syw963/newton-acoustic-camera/작업파일/빔포밍/예시결과/두음원/direction.png

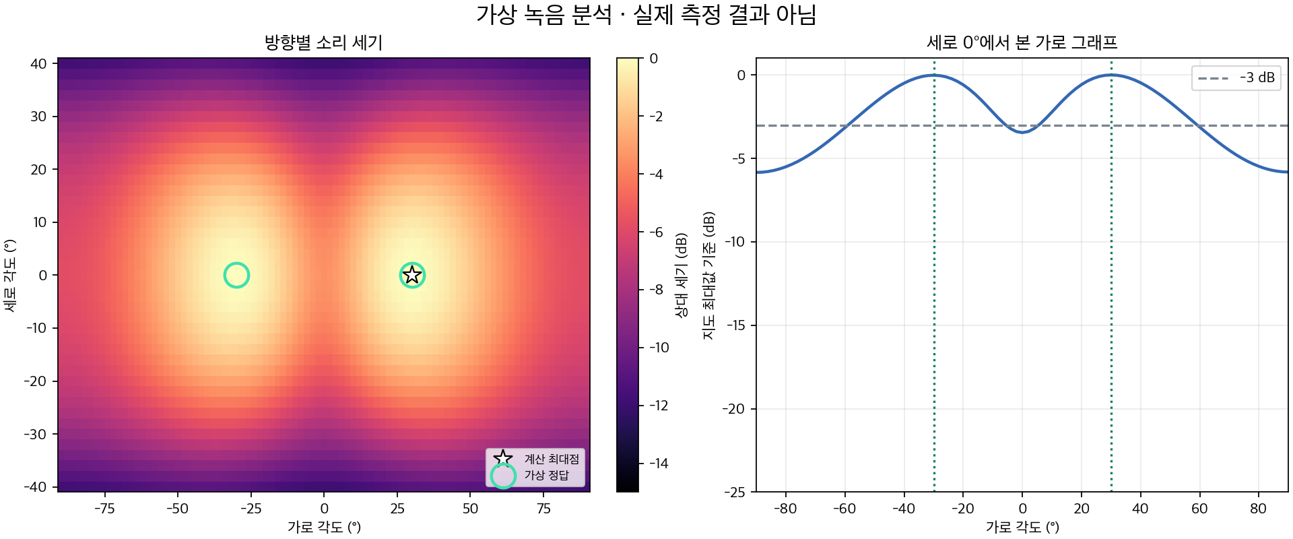
작업파일/빔포밍/예시결과/두음원/direction.png
