syw963/newton-acoustic-camera/README.md

# 뉴턴 음향카메라

물리 동아리(민족사관고) 활동. UMA-16 v2 마이크 배열과 카메라로 음향카메라를 만들고, 소리 방향 추정의 정확도를 빔포밍과 딥러닝으로 비교한다. 기간 8주, 인원 4~6명.

## 폴더 구성

| 경로 | 내용 |
|---|---|
| `진행상황.md` | 날짜별 진행 기록, 현재 상태, 다음 할 일 |
| `설계_및_결정사항.md` | 확정된 장치 설계, 요구서 작성 규칙, 확인이 필요한 것 |
| `CLAUDE.md` | Claude와 작업할 때의 지침 |
| `요구서/` | 학교 제출용 물품 구입 요구서 (xls) |
| `문서/` | 실험 계획서, 배선 작업 순서, 프로젝트 소개 문서, 장치 구상도 |
| `문서/보관/` | 이전 판 (10/15 선생님 제출본 계획서, 계획서 초안) |
| `작업파일/` | 요구서·계획서를 다시 만들 때 쓰는 원본, 아두이노 스케치, 실험용 소리 파일 |

## 현재 최종본

- **요구서 (제출본):** `요구서/음향카메라_물품구입요구서_100만원.xls`
- **요구서 (기존 버전):** `요구서/음향카메라_물품구입요구서_기존버전.xls` (보쉬 드릴, 하코 FX-888DX 등 상위 구성)
- **실험 계획서 (10/26 수정판):** `문서/음향카메라_실험계획서.docx` (수정용), `.pdf` (4쪽, 금액 없음). 10/15에 드린 판은 `문서/보관/음향카메라_실험계획서_1015제출본.*`
- **배선 작업 순서:** `문서/배선_작업순서.md` — 연결표, 단계별 확인, 문제 해결
- **프로젝트 소개 문서:** `문서/음향카메라_프로젝트_소개.docx`, `.md` (10/7 처음 구상. 실험 순서·예산이 바뀐 구버전이라는 안내를 맨 앞에 넣음)
- **장치 구상도:** `문서/음향카메라_장치구상도.html` (브라우저로 열기. 10/26 수정판 설계 반영)

## 방향 계산 실행과 결과

UMA-16과 스피커 A를 연결하고 프로젝트 폴더의 터미널에서 다음을 실행하면 시험 소리 재생·녹음·방향 계산·결과 저장을 한 번에 수행한다.
다른 컴퓨터의 최초 설치 방법과 실제 마이크 녹음 입력법은 [빔포밍 안내](작업파일/빔포밍/README.md)에 있다.

```sh
.venv/bin/python 작업파일/빔포밍/main.py --record
```

USB 단자가 아래인 UMA-16의 확인된 채널 순서를 기본으로 사용한다. 출력은 앰프로 연결한 이어폰 단자로 선택한다.
결과 폴더의 `direction.png`가 그림, `summary.csv`가 각도 요약, `recording.wav`가 원본이다.
장비 없이 시험하려면 `--record` 대신 `--demo`를 사용한다. 실제 장비의 방향 정확도는 후속 측정으로 확인한다.

바로 볼 수 있는 결과: [단일 음원 그림](작업파일/빔포밍/예시결과/단일음원/direction.png) · [요약 표](작업파일/빔포밍/예시결과/단일음원/summary.csv) · [두 음원 그림](작업파일/빔포밍/예시결과/두음원/direction.png).
이 예시는 **가상 16채널 녹음**으로 생성했으며 실제 장비의 측정 결과가 아니다. CSV는 엑셀·Numbers에서 열 수 있다.

## 작업파일

- `작업파일/빔포밍/` — 현재 방향 계산의 개발 위치. 계획서의 지연-합 빔포밍으로 녹음의 방향별 세기·최대 방향·소리 지도를 계산한다. 목적·입출력·실행법은 폴더의 `README.md`. UMA-16 직접 녹음·실제 WAV·가상 녹음 지원, 실물 정확도는 미검증.
- `작업파일/방향추정/locate_sound.py` — 이전 단계의 도착 시간차 연습 코드. 추가 설치 없이 `python3 작업파일/방향추정/locate_sound.py --demo`로 실행한다. 계획서의 지연-합 빔포밍 개발은 위 폴더에서 이어 간다.
- `작업파일/실험계획서/content.py` — 계획서 본문. 고친 뒤 `python build2.py`(pdf) → `node make.js`(docx)
- `작업파일/아두이노/turntable/turntable.ino` — 회전판 제어·배선 테스트 (명령: `?`, `w`, `e1/e0`, `m`, `h`, `g`, `z`)
- `작업파일/신호/make_signals.py` — 실험용 소리 파일 생성. 만들어 둔 파일은 `signals/` (채널 확인용 `00_채널확인.wav` 포함)
- `작업파일/요구서/` — 요구서 작업본 xlsx

## 관련 링크

- 프로젝트 소개 문서 (Claude Docs): https://claude.ai/code/artifact/5a2a508f-ef5b-42dd-a944-30aa85363ba6
- 장치 구상도 (HTML): https://claude.ai/artifact/AYDeXSYpjeCekpr5JsAYyh — 10/26 오전 설계 기준. 폴더의 html(검토 반영판)이 더 최신
