syw963/newton-acoustic-camera/설계_및_결정사항.md

# 설계 및 결정사항

## 탐구 질문과 실험

1. **방향 정확도와 빔 폭 (실험 1):** 회전판으로 배열을 −60°~+60° 범위에서 5° 간격으로 돌리며 측정한다.
   - 스피커 A는 1.5m 앞에 둔다.
   - 1·2·4·6·8 kHz 순음과 백색잡음을 쓰고, 3회 반복한다.
   - 기온으로 음속을 보정한다: v = 331.3 + 0.606T.
   - 빔포밍 계산 범위는 ±90°로 두고, 카메라 화면에 겹칠 때만 화각(가로 약 ±40°)으로 자른다.
   - 보정 전 치우침(평균 오차)과 흩어짐(표준편차)을 따로 보고한다. 0° 보정에 쓴 치우침을 정확도에 섞지 않는다.
   - 빔포밍 방향을 0°로 고정하고 회전 데이터를 그리면 실측 빔 패턴이 된다. 이것으로 주파수별 빔 폭을 재고, 6·8 kHz에서 앨리어싱을 본다.
2. **분해능 (실험 2):** 스피커 A·B 사이 각도 Δθ를 줄여 가며 두 봉우리 사이에 골이 생기는 최소 Δθ를 찾는다.
   - 시작 각도: 2 kHz 90°, 4 kHz 50°, 6·8 kHz 30°. 5°씩 줄이고, 합쳐지는 근처에서는 2.5°씩 줄인다. 1 kHz는 분리되지 않음을 보는 대조 조건이다.
   - 소리는 좌우 채널에 서로 다른 난수로 만든 1/3옥타브 대역 잡음이다. 같은 주파수 순음 두 개는 결맞음이라 쓰지 않는다. 파일은 `작업파일/신호/make_signals.py`로 만든다.
   - Δθ는 회전판으로 잰다. 스피커를 하나씩 켜서 정면(0°)에 오는 모터 각도의 차이를 쓰고, 줄자는 확인용으로만 쓴다.
   - 이론값 0.886 λ/D, D = 4 × 42 = 168mm. 정확한 계산값은 2 kHz 약 55°, 4 kHz 약 27°, 6 kHz 약 18°이다. 골이 생기기 시작하는 Δθ는 빔 폭(−3 dB)과 거의 같다.
   - 앨리어싱 시작 주파수는 음원 방향에 따라 다르다: 정면 음원 약 8.2 kHz, 20° 약 6.1 kHz, 35° 약 5.2 kHz, 60° 약 4.4 kHz. 4 kHz 이하에서는 생기지 않는다.
3. **빔포밍 vs 딥러닝 (실험 3):** 연필 0° 표시와 `o` 명령으로 원점을 잡고(단순판에는 리밋 스위치가 없음) ±60° 안의 무작위 각도(연속값)로 데이터를 자동 수집한다. 코드는 `작업파일/딥러닝/`.
   - 시작할 때와 50회마다 0°로 돌아가 빔포밍이 ±3° 안인지 확인하고, 어긋나면 멈춘다(스텝 손실 확인).
   - 시험 데이터는 다른 공간, 다른 날, 다른 거리 중 하나 이상이 다른 조건에서 따로 모은다. 같은 세션의 데이터를 무작위로 나눠 시험하지 않는다(data leakage).
   - 입력은 GCC-PHAT(120쌍 × ±32표본, 300~8000 Hz), 출력은 연속 각도(regression). 신경망은 1차원 합성곱(약 30만 매개변수). 가짜 녹음으로 사전 학습한 뒤 실제 데이터로 이어서 학습한다. 학습은 Mac에서도 되며, 데이터가 많아지면 RunPod에서 한다.
   - 세션 구분: 학습 세션 여러 개, 검증 세션 1개(다른 거리), 시험 세션 1개(다른 장소). 학습 중 가장 좋은 모델은 검증 세션으로 고른다.
   - 비교 대상은 지연-합 빔포밍, SRP-PHAT, MUSIC이다. 평균 오차와 최대 오차를 비교한다.

일정(임의 배분): 1~3주 장치 제작, 4주 실험 1, 5주 실험 2, 6~8주 실험 3.

## 장치 설계

**회전판 구성**
- 12mm 자작합판 상자, NEMA17(17HS4401) 모터
- 아두이노 UNO + CNC 쉴드 V3 + A4988 (1/16 마이크로스텝, 3200스텝/회전), 12V 2A 전원
- 이동은 매번 원점 기준 절대 스텝 수(각도 ÷ 360 × 3200, 반올림)로 한다.
- 제어 스케치: `작업파일/아두이노/turntable/turntable.ino` (명령 ? w e m h g z o)

**재단 치수:** 600×600 원판 2장 중 1장만 재단하고, 1장은 여분이다.

| 부품 | 치수 (mm) | 수량 |
|---|---|---|
| 바닥판·모터판 | 250×250 | 2 |
| 회전판 | 200×200 | 1 |
| 세움판 | 220×170 | 1 |
| 옆벽 | 250×70 | 2 |

**단순판 (2026-11-12 결정)** 제작이 너무 어려워 아래처럼 바꿨다. 순서는 `문서/회전판_제작가이드_단순판.html`(claude.ai 아티팩트)을 따른다. 11/4 가이드는 참고용으로 남긴다.
- 레이지수전 아랫판은 목재 나사 3.5×10으로 모터판에 박는다(윗판을 45° 돌려 모서리 구멍을 드러냄). 윗판은 얇은 양면테이프로 회전판에 붙인다. 회전은 플랜지가 시키고 레이지수전은 무게만 받으므로 볼트·너트·접근 구멍이 필요 없다.
- 리밋 스위치를 달지 않는다. 원점은 회전판과 모터판 앞 모서리의 0° 연필 표시를 맞춘 뒤 `o`로 정하고, 정면 스피커를 빔포밍으로 재서 미세 조정한다. 켤 때마다 다시 한다.
- 접시 구멍은 바닥판 아랫면 6곳만 판다. 세움판 나사를 레이지수전 자리(축에서 ±76) 바깥인 x = ±84, ±94로, 받침대 나사를 x = ±90으로 옮겨 회전판 아랫면 접시 구멍을 없앴다.
- 플랜지 볼트 구멍은 Ø4. 플랜지는 X자(대각선)로 놓아 뒤쪽 볼트 머리가 세움판에 닿지 않게 한다. 회전판 가운데를 5 mm로 먼저 뚫고 5 mm 비트를 핀으로 써서 플랜지를 가운데에 맞춘다.
- 커플링 높이 H = 모터판 두께 + 레이지수전 높이(약 21), 모터 앞면에서 플랜지 윗면까지.
- 카메라는 세움판 윗모서리 가운데에 집게로 끼운다(Ø32 구멍 없음).
- 모터판 구멍은 `문서/모터판_구멍본.pdf`(실제 크기)를 대고 뚫는다.

**레이지수전 회전 베어링**
- 사각 6인치, 높이 9mm. 모터판과 회전판 사이에 넣어 회전판 무게를 받는다.
- 볼트 세트의 M4×20+너트로 고정한다. 윗판은 회전판에 먼저 고정하고, 아랫판은 레이지수전을 45° 돌려 드러난 모서리 구멍을 9mm 틈으로 조인다.

**플랜지 커플링 (5mm)**
- 회전판 아랫면에 붙이고, 통 부분이 모터판의 Ø25 구멍 안으로 들어가게 한다.
- 모터 축 끝이 회전판을 약 3mm 넘으므로 회전판 가운데에 Ø8 구멍을 뚫는다.

**조립 순서 (조립 후에는 커플링 고정나사에 렌치가 닿지 않음)**
1. 커플링을 모터 축에 먼저 끼우고 고정나사(무두볼트)를 조인다.
2. 모터를 모터판 아래에서 올려 M3×16으로 고정한다. 커플링이 Ø25 구멍을 통과해야 한다.
3. 레이지수전 윗판을 회전판에 고정한다.
4. 레이지수전 아랫판을 모터판에 고정한다.
5. 회전판을 덮고 플랜지를 회전판에 고정한다.

물품이 오면 확인할 것:
- 플랜지 지름이 25mm보다 크면 모터판 구멍을 32mm 스페이드 비트로 넓힌다. 모터 볼트 구멍과의 벽 두께는 약 4mm 남는다.
- 커플링 전체 높이가 약 19mm 이하여야 한다. 이 값은 모터 보스 윗면에서 회전판 아랫면까지의 거리이다.
- 플랜지 구멍에 나사산이 있어야 위에서 볼트로 고정할 수 있다. 나사산이 없으면 고정 방법을 다시 정한다.

**고정 볼트**
- 모터: M3×16 4개
- UMA-16: M3 서포트(암-암 10mm)로 10mm 띄운다. 뒤쪽은 M3×16, 앞쪽은 M3×6.

**리밋 스위치** (단순판에서는 달지 않음. 아래는 나중에 달 때 참고)
- OMRON SS-5 장레버를 측정 범위 밖인 약 −70°에 단다. 회전판 아랫면 가장자리의 나사 머리가 레버를 누르게 한다.
- COM은 쉴드 X− 단자의 GND에, NO는 신호 핀(D9)에 연결한다. 눌리면 LOW이다.
- 남는 1개는 +70° 비상 정지로 X+ 단자(같은 D9)에 단다.
- 원점 찾기는 200° 안에서 스위치를 못 찾으면 멈춘다(선이 끊겼을 때 회전판이 계속 도는 것을 막음).

**녹음 중 모터 드라이버**
- A4988은 멈춰 있어도 전류를 흘려 고음 잡음을 낼 수 있다. 무음 녹음을 드라이버를 켠 상태(e1)와 끈 상태(e0)로 비교한다.
- 잡음이 있으면 녹음하는 동안 드라이버를 끈다.
- 드라이버를 끄면 모터가 가장 가까운 정지 위치(1.8° 간격)로 끌려갈 수 있다. 카메라 십자선으로 밀리는지 먼저 확인한다.
- 밀리면 드라이버를 켜 둔 채 녹음하거나, 측정 각도를 1.8°의 배수로 정한다.

**기타**
- 배열 중심 높이는 책상 위 약 200mm이다.
- 0°는 원점을 찾은 뒤 카메라 화면 중앙 십자선으로 맞추고(스케치의 z 명령), 실험 1 결과에서 일정하게 치우친 만큼을 보정한다. 레이저 포인터는 쓰지 않는다.
- 배열과 스피커 사이에서 책상 면에 반사되는 지점(배열 앞 약 0.75m)이 책상 위면 천을 깐다.

**음원**
- 2인치 4Ω 스피커 2개를 합판 통에 넣는다.
- 앰프는 PAM8403 모듈(동신전자 PP-A193)이다. USB 단자가 없으므로 USB 전원 케이블의 DC 플러그를 잘라 5V 단자에 납땜한다. 5V 넘는 전원을 넣지 않는다.
- 노트북 왼쪽 채널은 스피커 A, 오른쪽 채널은 스피커 B로 보낸다. 노트북의 소리 향상·공간 음향 기능은 끈다.
- PAM8403은 BTL 출력이다. L−와 R−를 묶거나 GND에 연결하지 않는다. 스피커마다 2심 선을 따로 쓴다(10m 선을 반으로 자름).
- 배선 순서와 확인 방법은 `문서/배선_작업순서.md`에 있다.

**소리 재생과 동시 녹음** (`작업파일/sh/sound_io.py`, 사용법은 같은 폴더의 `사용법.md`)
- Windows와 Mac에서 같은 코드로 돈다(sounddevice, soundfile). Windows에서는 WASAPI 장치를 고른다. 기본 볼륨 0.3은 `audio.py`와 같다.
- 스피커 선택: A = 왼쪽 채널만, B = 오른쪽 채널만, AB = 파일 그대로. A 전용 파일을 B로 고르면 오른쪽으로 옮겨 낸다.
- 녹음을 먼저 시작하고 0.3초 뒤 재생, 소리가 끝나고 0.5초 뒤 정지한다. 녹음은 16채널, 48 kHz, 16비트 wav이다.
- 재생과 녹음은 서로 다른 장치라 시계가 다르다. 빔포밍은 마이크 사이 시간차만 쓰므로 재생 시작 시각은 참고값(`play_offset_s`)으로만 남긴다.

**드릴 비트**
- 스페이드 비트 25mm: 모터판 구멍 (플랜지가 크면 32mm)
- 스페이드 비트 32mm: 카메라 선 구멍
- HSS 2mm: 나사 기초 구멍
- HSS 4mm: M3 구멍 (여유 있게 뚫어 모터 중심을 맞춤)
- HSS 5mm: M4 구멍
- HSS 8mm: 축 구멍

## 요구서 작성 규칙

- 사용자가 마지막으로 올린 xls를 기준으로 수정한다.
- 링크를 받은 상품만 교체하고, 나머지는 유지한다.
- 가격은 11번가 주문 영역의 할인모음가(자동적용 쿠폰 반영가)로 넣는다.
  - 쿠폰은 화면마다 다를 수 있으므로, 사용자 화면에 보이는 가격이 있으면 그것을 우선한다.
- 행을 넣거나 빼면 다음을 함께 고친다.
  - 번호
  - J열 수식(=D*I)과 합계(SUM)
  - 국내 배송비 금액과 L열 배송비 내역
- 같은 판매처 상품은 묶음배송으로 보고 배송비를 한 번만 넣는다.

## 소프트웨어 초기 연습 (이전 단계, 2026-11-04)

- 사용자는 소프트웨어 팀이며 실제 마이크 녹음 파일은 아직 없다. `작업파일/방향추정/`에 가상 녹음으로 실행할 수 있는 첫 버전을 둔다.
- 첫 출력 좌표는 가로·세로 **각도(도)**이다. 마이크의 앞쪽에 한 음원이 있다고 가정하며 거리나 방 안의 미터 좌표를 추정하지 않는다.
- 계산은 일반 상호상관으로 구한 도착 시간차와 평면파 근사를 쓴다. 실험 계획의 지연-합 빔포밍·GCC-PHAT·딥러닝 구현을 대신하는 완성본은 아니다.
- `mic_positions_example.csv`는 구상도에 있는 좌표의 예시이다. 실제 입력에는 동시 녹음의 각 채널과 순서를 맞춘 별도 좌표 파일이 필요하다. 실제 채널 순서와 좌우·상하 방향을 검증하기 전에는 실험 결과로 사용하지 않는다.
- 실제 녹음을 받으면 넓은 주파수의 한 음원으로 먼저 검증한다. 단일 순음, 여러 음원, 교실 반사음에서의 정확도는 아직 검증하지 않았다.

## 소프트웨어

- 연결: UMA-16·카메라·아두이노는 USB 허브로 노트북에 연결한다. UMA-16은 아두이노에 연결하지 않는다(아두이노는 모터만 다룬다). Mac에서는 "UMA16v2, 입력 16/출력 2"로 보인다.
- 실험 노트북은 Windows와 Mac을 모두 지원한다. 파이썬 3.9 이상, 패키지는 `작업파일/파이썬/requirements.txt`(numpy, pyserial, sounddevice, soundfile).
- 회전판은 `turntable.py`의 `Turntable`로 조작한다. 명령 한 줄을 보내고 `ok`가 올 때까지 기다리며, `err`는 `TurntableError`로 처리한다. `Turntable("sim")`은 turntable.ino를 흉내 내는 시뮬레이터이다.
- 소리는 `audio.py`로 낸다. 스피커 A = 왼쪽 채널, B = 오른쪽 채널, 표본화 주파수 48 kHz. 기본 볼륨 0.3에서 시작한다.
- 조립 전에는 벤치 원점(`o`, `--bench`)으로 책상 위에서 시험하고, 실험에서는 리밋 스위치로 잡은 원점(`h`)만 쓴다.
- 실제 하드웨어를 처음 켤 때는 `hw_check.py`로 점검하고 결과를 `작업파일/파이썬/기록/`에 남긴다.
- UMA-16은 `uma_check.py`로 점검한다(장치 정보, 16채널 레벨, `--map`으로 채널 위치표).
- 지연-합 빔포밍은 `beamform.py`(좌표, 각도별 세기 `scan`, 가짜 녹음 `simulate`)와 `step4_beamform.py`(녹음 → 계산 → `기록/bf_log.csv`)로 한다. 녹음·재생은 팀원의 `작업파일/sh/sound_io.py`를 복사하지 않고 불러 쓴다. 기본 대역 300~4000 Hz, 1/2 겹침 1024점 STFT.

**UMA-16 채널 위치표 (2026-11-11, Mac, 48 kHz)**
- 마이크를 하나씩 긁어 가장 크게 들은 채널을 적었다. 16개 모두 2위 채널보다 6 dB 이상 컸다. 기록: `작업파일/파이썬/기록/uma_map_20261111_155005.md`.
- 위치 기준: 마이크 면을 마주 보고(스피커 쪽에서 배열을 볼 때) 위쪽이 1행, 왼쪽이 1열이다. 이때 USB 단자는 아래쪽에 있었다. 보드를 세움판에 달 때도 마이크 면이 스피커를 보고 USB 단자가 아래로 가게 단다(다르게 달면 표를 돌려서 쓴다).
- 좌표: 배열 중심이 원점, x는 오른쪽 +, y는 위쪽 +, 간격 42mm. 각도 부호는 팀 논의 D3에서 정한다.

| | 1열 (x −63) | 2열 (x −21) | 3열 (x +21) | 4열 (x +63) |
|---|---|---|---|---|
| 1행 (y +63) | ch8 | ch7 | ch10 | ch9 |
| 2행 (y +21) | ch6 | ch5 | ch12 | ch11 |
| 3행 (y −21) | ch4 | ch3 | ch14 | ch13 |
| 4행 (y −63) | ch2 | ch1 | ch16 | ch15 |

- 왼쪽 두 열이 ch1~8, 오른쪽 두 열이 ch9~16이다. 채널 번호는 녹음 파일의 열 순서(1부터)이다.
- `작업파일/파이썬/beamform.py`의 각도 약속(임시, D3에서 확정): 0°는 배열 정면, 배열 뒤(카메라 쪽)에서 스피커를 볼 때 오른쪽이 +θ이다. +θ 쪽에 ch1~8 열이 있어 +θ 소리가 ch1~8에 먼저 닿는다. 11/11 책상 위 시험에서 오른쪽 스피커가 +, 왼쪽 스피커가 −로 나와 위치표와 부호가 맞음을 확인했다. `작업파일/빔포밍/`은 마이크 면을 마주 본 x축을 각도에도 사용하므로 같은 녹음의 가로 부호가 반대이며 비교 시 부호를 바꿔 맞춘다.
- 빔포밍 코드에서 쓰는 좌표(mm, 채널 순서, 0번 = ch1):

```python
MIC_XY_MM = [(-21, -63), (-63, -63), (-21, -21), (-63, -21), (-21, +21), (-63, +21), (-21, +63), (-63, +63),
             (+63, +63), (+21, +63), (+63, +21), (+21, +21), (+63, -21), (+21, -21), (+63, -63), (+21, -63)]
```
- 순서: 하드웨어 조작(완료) → 16채널 녹음 + 지연-합 빔포밍(책상 위, 회전판 없이) → 카메라 겹치기 → 자동 수집 → 실험 3 딥러닝. UMA-16이 일찍 도착해 가짜 데이터 시뮬레이터 단계는 건너뛴다.

**방향 계산의 현재 개발 기준 (2026-11-04)**
- 개발 위치는 `작업파일/빔포밍/`이다. 목적·입출력·좌표·범위·실행법은 해당 폴더의 `README.md`에 정리한다. 이전 시간차 연습 폴더는 보관한다.
- 입력은 동기화된 다채널 WAV, 채널 순서를 확인한 마이크 좌표 CSV, 기온, 분석 주파수 대역이다. 정답 각도나 모터 위치를 계산 함수에 주지 않는다.
- 계획서의 주파수 영역 지연-합 빔포밍을 구현한다. Hann 창·50% 겹침으로 CSM을 평균하고 대각항을 유지한다. 상대 채널 크기를 임의로 같게 만들지 않는다.
- 출력은 최대 방향의 가로·세로 각도, 전체 방향별 세기, 소리 지도와 세로 0°의 가로 그래프이다. 지도 최대값 기준 상대 dB이며 소음도나 정답 확률은 아니다.
- 가로 ±90°, 세로 ±40°, 기본 2° 간격으로 탐색한다. 앞쪽 음원·평면파를 가정하며 거리·미터 좌표를 추정하지 않는다. 기본 대역 500~4000Hz는 실험 주파수에 맞춰 바꾼다.
- 예시 CSV는 가상 시험용이다. 실제 입력은 11/11에 확인한 채널 순서를 옮긴 `mic_positions_uma16_usb_down.csv`를 기본으로 사용한다(USB 아래, 마이크 면을 마주 본 좌표). 다른 방향·다른 채널 순서는 별도의 좌표 CSV를 지정한다. 가상 결과에 실물 측정과 구분되는 표시를 붙인다.
- 구상도 좌표의 최외곽 마이크 중심 간격(126mm)과 기존 근사식의 D(168mm)는 정의를 구분해 검토해야 한다. 이번 빔포밍은 D 근사식을 쓰지 않고 개별 마이크 좌표로 계산한다.
- 현재는 한 번의 녹음 또는 저장된 파일 하나의 방향 계산 단계이다. 연속 실시간 화면·영상 합성·회전판 자동 수집·딥러닝·실험 1~3 전체 평가는 후속 작업이며 실물 정확도는 아직 검증하지 않았다.

**직접 녹음과 방향 계산 연결 (2026-11-11)**
- `main.py --record`로 팀원의 `작업파일/sh/sound_io.py` 원본을 불러와 `exp3_white`를 스피커 A에서 재생하고 UMA-16으로 녹음한 뒤 계산·그림·표 저장까지 이어 간다. 녹음 도구 원본을 복사하거나 수정하지 않는다. 아두이노는 조작하지 않는다.
- 마이크는 16채널·48 kHz, 저장은 PCM16이다. 입력은 UMA-16 자동 선택, 출력은 시스템 기본값이며 `--mic`·`--out`으로 지정할 수 있다. `--devices`는 목록만 표시한다.
- 원본 `recording.wav`를 먼저 보존한다. 녹음 스트림 경고·최대 크기의 99% 이상인 샘플·시험 소리가 잡히지 않은 경우에는 방향 계산을 멈추고 `recording_info.json`에 이유를 적는다.
- 구간은 재생 전 첫 0.2초의 바닥 잡음 대비 3배 이상인 20ms RMS가 0.2초 이상 이어진 가장 긴 부분으로 고른다(최소 RMS 1e-5). 장치 간 시계 차이가 있는 `play_offset_s`로 자르지 않는다. 이는 녹음 상태 선별이며 음원 식별·방향 정확도를 보증하지 않는다.
- 장비를 흉내 낸 통합 시험을 포함해 빔포밍 테스트 18개와 팀원 녹음 도구의 장치 없는 테스트 8개를 통과했다. 이 변경 중 실제 녹음·재생은 실행하지 않았으며 실제 장비 방향 검증은 별도이다.

**결과 출력과 공유 (2026-11-11)**
- 기본 결과는 `작업파일/빔포밍/결과/`에 저장한다. `--output-dir`로 새 저장 폴더를 지정할 수 있으며 기존 폴더를 덮어쓰지 않는다.
- PNG·JSON·NPZ와 함께 요약(`summary.csv`), 가로 그래프(`direction_curve.csv`), 전체 지도(`power_map.csv`)를 출력한다.
- GitHub 공유용 가상 데이터 결과는 `작업파일/빔포밍/예시결과/`에 선별해 보관한다. 실제 측정과 구분하고, 원본 가상 WAV·전용 Python 환경·캐시는 업로드 대상에서 제외한다. 결과 JSON에는 파일 이름을 저장한다.

## 문서 원본

- 실험 계획서 본문은 `작업파일/실험계획서/content.py` 하나에서 고친다.
- `build2.py`를 실행하면 pdf와 data.json이 만들어지고, 이어서 `node make.js`를 실행하면 docx가 만들어진다. 결과는 `문서/`에 저장된다.
- 실험용 소리 파일은 `작업파일/신호/make_signals.py`로 만든다.

## 확인이 필요한 것 / 주의

- **11번가 판매 종료:** 자주 일어난다. 10/13 PAM8403, 10/14 커플링·모터 케이블이 내려갔다. 주문 직전에 다시 확인한다.
- **Claude가 열 수 없는 페이지:** 쿠팡과 네이버 스마트스토어. 사용자가 직접 확인한다.
- **해외직배송 상품:** 드릴(Tempo11)과 커플링은 해외직배송이라 도착이 늦을 수 있다. 요구서 납품기한(10/28)과 맞지 않는다.
- **UMA-16 비용:** 국제 배송비($30)와 관세는 결제 화면에서 확정되는 예상값이다. 환율 1,350원은 10/26 시세(약 1,323원)보다 여유 있게 잡은 값이다.
- **요구서 배송비 내역:** 판매처 4곳(#4 스테핑모터 컨트롤러, #7 웨이투샵, #19 에이치케이오토모바일, #35 동백산업)이 유료·무료 어느 쪽에도 적혀 있지 않다. 모두 유료여도 약 1.2만 원이라 100만 원 안이다.
- **100만 원 버전의 한계:** 등급을 낮춘 품목은 드릴(WORX 12V), 스페이드 비트(포스너 대신), 미니톱이다.
