syw963/newton-acoustic-camera/진행상황.md

# 진행상황

## 현재 상태 (2026-11-13)

- 구입 요구서: 100만 원 버전 확정 (974,655원). 선생님 검토 중. 요구서 파일은 이번에 고치지 않음.
- 실험 계획서: 10/15에 선생님께 드린 판(`문서/보관/…_1015제출본`)에서 실험 1~3을 고친 수정판을 만듦 (docx, pdf 4쪽). 선생님께 다시 드릴지는 아직 정하지 않음.
- 배선: 배선 작업부터 시작할 예정. 순서·확인 방법은 `문서/배선_작업순서.md`, 테스트 스케치와 소리 파일 준비됨.
- 부품 도착: UMA-16이 도착해 모든 물품이 도착함(11/11). Mac 오디오 MIDI 설정에서 "UMA16v2, 입력 16/출력 2"로 인식됨. 표본화 주파수 48 kHz 확인, 16채널 모두 동작, 채널 위치표 작성(`uma_check.py`, 설계_및_결정사항.md, USB 단자 아래 기준).
- 연결 구조: UMA-16·카메라·아두이노는 USB 허브로 노트북에 연결한다. UMA-16은 아두이노에 연결하지 않는다(아두이노는 모터만).
- 장치 제작(목공): 시작 전. 제작 가이드(`문서/음향카메라_제작가이드.html`, claude.ai 아티팩트)를 만듦. 실측 후 팀 논의(D1~D7)로 확정할 예정.
- 소프트웨어: 하드웨어 조작 첫 단계 코드(`작업파일/파이썬/`)와 팀 소개 페이지(`문서/소프트웨어_첫걸음.html`, claude.ai 아티팩트)를 만듦. 실제 하드웨어용 점검 스크립트(`hw_check.py`)와 조립 전 벤치 원점(`o`)을 추가함. 시뮬레이터로만 시험했고 실제 아두이노·스피커로는 아직 안 돌려 봄.
- 소리 재생 자동화(소프트웨어 팀원 담당, 작업 폴더 `작업파일/sh/`): `sound_io.py` 첫 판. 재생(A만/B만/AB, 반복), UMA-16 동시 녹음, Windows·Mac 공용. 장치 없는 시험, Windows 이어폰 시험(좌우·높낮이), Windows selftest(노트북 스피커·마이크로 동시 재생·녹음) 통과, Mac 시험 통과(팀장). 앰프·스피커 배선 완료(하드웨어 팀). 실제 스피커 시험 통과(A/B 방향, 잡음 없음, 앰프 볼륨 위치 정함). UMA-16은 아직 안 함.
- 딥러닝(실험 3, 11/13): `작업파일/딥러닝/`에 수집 → 특징(GCC-PHAT) → 학습 → 4가지 방법 비교 파이프라인을 만듦. 가짜 녹음으로 끝까지 돌아감(DNN 평균 오차 0.50°). 실제 녹음에는 아직 맞지 않아(빔포밍과 10~25° 차이) 회전판 수집 데이터가 필요함.
- 장치 구상도: 수정판 설계를 반영함. claude.ai 아티팩트는 아직 이전 버전.
- GitHub: 공개 저장소 syw963/newton-acoustic-camera에 폴더를 올림(11/3). 실명이 든 요구서 xls·작업본 xlsx는 제외. 로컬 폴더도 git 저장소로 연결함(origin/main).
- 방향 계산: 사용자는 소프트웨어 팀이며 실제 마이크 녹음 파일은 아직 없음. 목적·입출력을 정리하고 `작업파일/빔포밍/`에 계획서의 지연-합 빔포밍을 구현함. 가상 녹음 및 WAV 입력 → 방향별 세기·최대 방향 → PNG·JSON·NPZ 저장을 지원함. 가상 데이터 테스트 10개 통과. 실제 장비 정확도는 미검증. `작업파일/방향추정/`은 이전 연습 코드로 보관함.
- 결과 출력(11/11): 요약·방향별 그래프·전체 지도를 CSV 표로 추가 출력함. `작업파일/빔포밍/예시결과/`에 공유용 단일·두 음원 결과를 생성함. 실제 장비 측정이 아닌 가상 데이터 예시이며 테스트 11개 통과.
- GitHub 공유(11/11): 최신 팀 작업을 받아 합친 뒤 빔포밍 코드와 예시 결과 PNG·CSV·JSON·NPZ를 `origin/main`에 푸시함. 반영 커밋 `82b2223` 확인.
- 직접 녹음 연결(11/11): `작업파일/빔포밍/main.py --record`로 스피커 재생 → UMA-16 16채널 녹음 → 방향 계산 → PNG·CSV 저장을 연결함. USB 아래 기준으로 확인된 채널 순서를 기본 CSV에 반영함. 원본 녹음과 상태 기록을 남기며 녹음 경고·클리핑·시험 소리 미검출 시 계산을 멈춤. 장비를 흉내 낸 통합 시험을 포함해 빔포밍 테스트 18개, 팀원 녹음 도구 검사 8개 통과. 이 프로그램의 실제 장비 방향 시험은 아직 하지 않음.

## 다음 할 일

- [ ] 방향 계산: `.venv/bin/python 작업파일/빔포밍/main.py --demo` 실행 후 `direction.png`와 `summary.csv` 확인. `main.py`의 입력 → 계산 → 저장 흐름부터 이해
- [x] 확인된 마이크 채널 순서를 실제 입력용 좌표 CSV로 준비하고, 녹음과 방향 계산을 한 명령으로 연결
- [ ] UMA-16과 스피커 A 연결 후 `main.py --record` 실행. 정면·왼쪽·오른쪽의 알려진 위치에서 방향 부호·실물 오차 확인

- [ ] 팀원 각자 노트북에 파이썬 설치 후 step0~3을 `--port sim`으로 실행, 연습 과제 1~4
- [ ] 최신 `turntable.ino` 업로드(아두이노 IDE에서 확인·업로드, `o` 명령 추가됨) → `python hw_check.py`로 실제 하드웨어 점검, 결과 md를 기록에 남김 (Windows·Mac 각각)
- [x] 방향 계산의 첫 구현: 가짜 16채널 데이터 시뮬레이터 + 지연-합 빔포밍 (UMA-16 도착 전, 실제 장비 검증은 후속)

- [ ] 소리 재생(`작업파일/sh/`): ~~이어폰으로 A/B 확인, `selftest`~~(11/4 Windows 통과), ~~Mac에서도 확인~~(11/4 팀장 통과), ~~실제 스피커로 확인·앰프 볼륨 위치 정하기~~(11/4 통과) → UMA-16 16채널 녹음 확인 → 수집 프로그램에 `SoundIO` 연결
- [ ] UMA-16 개봉 점검
- [ ] ~~UMA-16 48 kHz 확인~~(11/11 Mac 확인), Windows 인식 확인, 카메라 인식 확인
- [ ] ~~16채널 녹음 시험과 채널 위치표~~(11/11 완료, USB 단자 아래 기준)
- [ ] UMA-16 보드 실측(제작 가이드 U1)
- [ ] ~~16채널 녹음 + 지연-합 빔포밍 (책상 위)~~(11/11 첫 시험 통과) → 다음: 스피커 위치를 줄자로 재서 각도를 정확히 넣기, ±15°로 모아 4 kHz 분리 경계, 2 kHz 분리 경계(60°~80° 사이), 앰프 볼륨 조금 올리기, 순음별 빔 폭
- [ ] 빔포밍 코드 정리: `작업파일/빔포밍/`과 `작업파일/파이썬/beamform.py` 모두 11/11 채널 위치표를 반영함. 앞에서 마이크를 보는 좌우와 뒤에서 스피커를 보는 좌우를 각각 써 가로 각도 부호가 반대이므로 통일 여부를 팀에서 정하기. 이전 `작업파일/방향추정/`은 예시 좌표의 연습 코드로 보관
- [ ] 배선: `문서/배선_작업순서.md` 1~5단계 (Vref 조정, 리밋 스위치 확인, 채널 확인 wav)
- [ ] 드라이버 잡음 테스트(e1/e0 무음 녹음 비교)와 드라이버를 끌 때 각도가 밀리는지 확인 → 결과를 설계_및_결정사항.md에 기록
- [ ] 단순판 가이드 0장 실측(모터판 두께, 레이지수전 높이·한 변·가운데 구멍, 플랜지 지름·나사산) → 결과 복사해 여기에 기록
- [ ] 단순판 준비물 구입: 목재 나사 3.5×10 8개, M3×16 2개 이상, 얇은 양면테이프 (플랜지 나사산 없으면 M3 너트·순간접착제)
- [ ] 단순판 가이드 1~17단계 진행
- [ ] 음향카메라 화면(`step5_acoustic_camera.py`) 실제 시험: 허브 다시 연결, 카메라를 배열 위 가운데에 같은 방향으로
- [ ] 팀 논의: D3 각도 방향(빔포밍 코드 두 개의 부호 통일 포함), D6 스피커 구멍, D7 역할. D1·D2·D4·D5는 단순판으로 정함
- [ ] 딥러닝: 회전판 완성 후 `collect.py --sim`으로 흐름 확인 → 실제 수집(학습 세션 2~3개, 검증 1개, 다른 장소 시험 1개) → `train.py --init 결과/sim1/model.pt` → `evaluate.py`. RunPod는 데이터가 수만 개로 늘 때 사용
- [ ] 실험 계획서 수정판을 선생님께 다시 드릴지 결정
- [ ] 장치 구상도 claude.ai 아티팩트를 폴더의 html로 갱신
- [ ] 선생님 검토 결과 반영 (요구서·실험 계획서)
- [ ] 요구서: 요구자 칸 날짜를 제출일로 수정, 드릴 규격 칸의 "10/27 도착 예정" 삭제, 납품기한(10/28)을 해외 배송 품목에 맞게 조정, 배송비 내역에 빠진 판매처 4곳 확인

## 기록

### 2026-11-13 (딥러닝 학습 구성)
- `작업파일/딥러닝/` 새로 만듦: `data.py`(가짜 녹음: 반사 1~3개·마이크 감도 ±1 dB·잡음 0~30 dB, 수집 폴더 읽기), `gcc.py`(120쌍 GCC-PHAT ±32표본, SRP-PHAT), `model.py`(1차원 합성곱, 출력 각도 1개), `collect.py`(회전판 무작위 각도 자동 수집), `make_dataset.py`, `train.py`(cuda/mps/cpu), `evaluate.py`(DAS·SRP-PHAT·MUSIC·DNN), README(RunPod 사용법 포함). PyTorch 설치.
- 가짜 녹음 4000개 학습(Mac mps 30회 약 30초) → 따로 만든 가짜 시험 300개: 평균/최대 오차 DAS 0.55°/4.6°, SRP-PHAT 0.25°/5.0°, MUSIC 1.13°/7.9°, DNN 0.50°/2.4°.
- 같은 모델을 11/11 실제 녹음 5개에 적용하면 DNN이 빔포밍과 10~25° 다름(예: 빔포밍 −39°, DNN −14°). 가짜 녹음만으로는 실제 방을 흉내 내지 못하므로 실제 수집 데이터로 학습해야 함. MUSIC도 실제 녹음에서 크게 틀림(원인 미확인).
- 단순판에는 리밋 스위치가 없어 `collect.py`는 연필 0° 표시 + `o`로 원점을 잡고, 시작과 50회마다 0°에서 빔포밍이 ±3° 안인지 확인해 어긋나면 멈추게 함.
- `데이터/`, `결과/`, `수집/`은 커서 .gitignore에 넣음.

### 2026-11-11 (음향카메라 화면)
- `작업파일/파이썬/step5_acoustic_camera.py`: 카메라 영상 위에 지연-합 소리 지도(가로·세로)를 실시간으로 겹침. `beamform.py`에 `arrival_delays_2d` 추가. 가짜 소리(+20°,+10° 등)로 칸 크기 안에서 맞히고 한 번 계산 5~15 ms 확인. OpenCV 설치.
- USB 카메라(icspring camera)는 OpenCV 0번, 1920×1080. 렌즈 덮개를 빼고 VS Code 카메라 권한을 허용해야 함.
- 실제 화면은 아직 확인 못 함: 실행 중 USB 허브 연결이 끊겨 UMA-16·카메라·이어폰 출력이 모두 사라짐. 허브를 다시 꽂고 시험해야 함.

### 2026-11-12 (장치 제작: 모터 고정)
- 판은 잘라 두었고 구멍은 아직 안 뚫음. 모터를 판에 고정하는 나사 위치 맞추기부터 어렵다고 함.
- 모터판 구멍 본(실제 크기 A4) `문서/모터판_구멍본.pdf`를 만듦(원본 `작업파일/도면/motor_template.py`). 판 중심선에 맞춰 붙이고 가운데 Ø25와 모터 나사 4개(31mm 간격)를 그대로 찍어 뚫는 방식. 인쇄 크기 확인용 50mm 자 포함. 모터 실물을 본 위에 올려 구멍이 맞는지 먼저 확인할 것.
- 단순안 A~C(레이지수전 목재 나사·양면테이프, 리밋 스위치 없음, 접시 구멍 최소화)로 정함. 제작 가이드 단순판 `문서/회전판_제작가이드_단순판.html`을 만들고 claude.ai 아티팩트로 올림(https://claude.ai/artifact/7MXQXq6khWs6h57sazZpQd, 비공개라 팀원에게 공유 필요). 17단계 + 스피커 통, 실측 5가지를 넣으면 커플링 높이·가운데 구멍 크기 등을 계산하고 단계별 확인 칸이 있음.
- 함께 바꾼 것: 세움판·받침대 나사를 레이지수전 자리 밖으로 옮겨 회전판 접시 구멍 제거, 플랜지 구멍 Ø4·X자 배치, 카메라는 집게로. 설계_및_결정사항.md에 반영.

### 2026-11-11 (직접 녹음에서 방향 결과까지 연결)
- `main.py --record`, `recording.py`를 추가해 팀원의 `SoundIO` 원본을 사용한 한 번의 녹음 후 자동으로 기존 빔포밍과 PNG·CSV·JSON·NPZ 저장을 실행하게 함. `--devices`, 입력·출력 장치 지정, 시험 소리·볼륨·스피커 선택도 지원함.
- 확인된 실물 채널 순서를 `mic_positions_uma16_usb_down.csv`로 옮김. 실제 입력의 기본 좌표로 사용하고 예시 CSV는 가상 시험용으로 보존함. 간격 42mm는 설계값이며 카메라·모터와의 각도 부호 일치는 후속 시험 항목임.
- 원본 PCM16 녹음과 상태 기록을 먼저 저장하고, 바닥 잡음보다 커진 구간을 자동 분석함. 입력 스트림 경고·클리핑·소리 미검출 시 결과 각도를 만들지 않음. 장치 오류는 안내 문구로 처리함.
- 프로젝트 `.venv`에 sounddevice 0.5.6을 설치함. 장치를 흉내 낸 녹음에서 (+20°, +10°) 추정과 원본·그림·CSV 저장, 실패 시 원본 보존, 잘못된 마이크 거부, 장치 목록 조회, 저장된 WAV의 기본 채널표 적용을 검증함. 빔포밍 18개와 기존 녹음 도구 8개 테스트 통과.
- 실제 마이크 녹음·스피커 재생은 실행하지 않음. 실제 연결·방향 정확도는 사용자와 장비 시험에서 확인해야 함. 사용자 Java 연습 파일은 수정하지 않음.
- 사용자 푸시 요청으로 팀원의 최신 `308650c`(책상 위 실제 녹음 시험 코드·기록)를 받아 합침. 진행 문서 충돌은 양쪽 기록을 보존해 해결하고 두 프로그램의 좌우 부호 차이를 안내함. 팀원의 실물 시험 통과와 이번 `main.py --record`의 장비 미시험 상태를 구분함.

### 2026-11-11 (결과 출력과 GitHub 공유)
- `--output-dir`로 프로젝트 내 원하는 새 폴더에 저장하는 옵션을 추가함. 기존 결과 폴더를 덮어쓰지 않음.
- `summary.csv`, `direction_curve.csv`, `power_map.csv`를 추가함. UTF-8 BOM으로 저장해 엑셀·Numbers에서 열 수 있게 함. 가상 녹음 여부와 실물 정확도 미검증 상태를 요약 표에도 기록함.
- `작업파일/빔포밍/예시결과/단일음원/`, `두음원/`에 가상 녹음 분석 결과 PNG·CSV·JSON·NPZ를 생성함. 원본 가상 WAV는 Git 업로드 대상에서 제외하고 재생성 명령을 README에 안내함. 결과 JSON의 절대 경로를 파일 이름으로 바꿈.
- 기존 계산 검증과 CLI 출력·CSV/NPZ 값 일치·기존 폴더 보존 검증까지 테스트 11개가 통과함. `프밍기 11.06.java`는 별도의 사용자 연습 파일로 두고 이번 공유 대상에서 제외함.
- GitHub에 새 팀 작업이 있어 푸시가 거절된 뒤, `git pull --no-rebase --no-edit origin main`으로 합치고 다시 푸시해 성공함. 빔포밍 작업과 예시 결과가 `origin/main`의 `82b2223`에 반영됐음을 확인함.

### 2026-11-11 (claude.ai 세션)
- UMA-16이 도착해 모든 물품이 도착함. 주문 전 확인 항목(11번가 가격, 쿠팡 접착제, WORX 충전기 문의)은 다음 할 일에서 뺌.
- 연결 구조를 정함: UMA-16·카메라·아두이노는 USB 허브로 노트북에 연결. UMA-16은 아두이노에 연결하지 않음(아두이노는 모터만).
- Mac 오디오 MIDI 설정에서 "UMA16v2, 입력 16/출력 2"로 인식됨을 확인. 표본화 주파수는 미확인.
- 다음 소프트웨어를 가짜 데이터 시뮬레이터 대신 실제 16채널 녹음 + 지연-합 빔포밍(책상 위, 회전판 없이)으로 바꿈.

### 2026-11-11 (UMA-16 점검)
- `작업파일/파이썬/uma_check.py`: UMA16v2를 찾아 장치 정보와 16채널 실시간 레벨을 보여 줌. `--map`으로 마이크를 하나씩 긁으면 가장 크게 들은 채널을 위치(1행 1열~4행 4열)에 적어 `기록/uma_map_날짜.md`에 저장함.
- Mac에서 실행: UMA16v2(Core Audio), 입력 16/출력 2, 기본 표본화 주파수 48000 Hz, 48 kHz 16채널로 열림. 16채널 모두 바닥 잡음 약 −78 dBFS(죽은 채널 없음).
- 채널 위치표를 만듦(`기록/uma_map_20261111_155005.md`, 설계_및_결정사항.md에 반영). 왼쪽 두 열이 ch1~8, 오른쪽 두 열이 ch9~16으로 규칙적이고, 16개 모두 2위 채널보다 6 dB 이상 큼.
- 첫 두 번의 시도는 실패함: 소리 끝 판정이 처음 잰 바닥 잡음에 묶여 있어 방 소리가 커지자 판정이 멈췄고, 백그라운드 실행이라 "다시 긁으세요" 안내가 사용자에게 보이지 않아 순서가 밀림. 끝 판정을 고치고(최대 3초), 기준을 바닥 잡음 +35 dB로 올리고, 받아들일 때 소리(띵)를 내게 함. 위치표는 사용자가 터미널에서 직접 실행해 만듦.
- 긁을 때 USB 단자는 아래쪽이었음(사용자 확인). 세움판에도 이 방향으로 달기로 함.

### 2026-11-11 (16채널 녹음 + 지연-합 빔포밍, 책상 위)
- `작업파일/파이썬/beamform.py`(채널 좌표, 각도별 지연-합 세기, 빔 폭, 가짜 녹음)와 `step4_beamform.py`(재생·녹음 → 계산 → 막대그래프, `기록/bf_log.csv`)를 만듦. 녹음은 팀원의 `작업파일/sh/sound_io.py`를 불러 씀.
- 가짜 소리(0°, +30°, −45°, +60°)로 점검: 모두 정확히 맞힘.
- 실제 시험: UMA-16을 세움(USB 아래), 스피커 A 백색잡음(exp1_white, 볼륨 0.3), 거리 약 1m, 각도는 대략으로 둠.
  - 처음 세 번은 앰프 쪽 소리가 거의 없어(잡음보다 0~6 dB) 쓸 수 없었음. 사용자가 고친 뒤 잡음보다 약 20 dB.
  - 결과: 정면 0° → +2°(빔 폭 37°), 오른쪽 약 30° → +35°(46°), 왼쪽 약 30° → −24°(40°).
  - 오른쪽이 +, 왼쪽이 −로 나와 채널 위치표와 각도 부호가 맞음을 확인함. 5~6° 차이는 놓은 위치가 대략적이고 책상 반사가 있어 생길 수 있는 크기.
- `bf_log.csv`의 첫 세 줄(16:04~16:05)은 소리가 들어오지 않은 녹음이라 분석에서 뺀다.

### 2026-11-11 (A·B 동시: 실험 2 미리 해 보기)
- `step4_beamform.py`에 여러 봉우리 찾기(최대 −6 dB 안)와 두 봉우리 사이 골 깊이(−3 dB 이하면 분리)를 넣음. `--true`, `--sim`에 각도 여러 개를 받음. `bf_log.csv`에 `peaks_deg` 열 추가.
- 가짜 소리 점검: ±30° 4 kHz 분리(골 −18 dB), ±30° 2 kHz 거의 합쳐짐(−0.4 dB), ±20° 4 kHz 분리(−4.7 dB), ±10° 4 kHz 합쳐짐. 이론 분해능(4 kHz 약 27°, 2 kHz 약 55°)과 맞음.
- 실제: 스피커 A 왼쪽 약 −30°, B 오른쪽 약 +30°(대략), 1/3옥타브 대역 잡음 `exp2_band_*k`(좌우 다른 난수), `--speaker AB`.
  - 1회: 4 kHz 봉우리 −19°, +31°, 골 −8.3 dB(분리). 2 kHz 봉우리 하나(+35°, 합쳐짐).
  - 2회: 4 kHz −23°, +48°, 골 약 −12 dB(분리). 2 kHz −22°·+54°의 완만한 언덕, 골 약 −2 dB(합쳐짐).
  - A만(4 kHz): −20°, 빔 폭 32°. A는 실제로 −20° 근처에 놓여 있었던 것으로 봄. B가 1회 +31°, 2회 +48°로 달라 B만 따로 확인 필요.
  - 같은 60° 간격에서 4 kHz는 분리되고 2 kHz는 합쳐짐: 실험 2의 핵심 현상을 책상 위에서 확인함.
- 사용자가 A만 낼 때도 B에서 소리가 났다고 해서 확인함: 코드는 A만 낼 때 오른쪽 채널을 0으로 보내고, Mac 모노 재생 설정은 꺼져 있음. 1 kHz를 A만 → B만으로 틀어 귀로 확인한 결과 정상(배선 문제 없음). 녹음에서도 B 쪽은 −14 dB 정도라, 들린 것은 반사음으로 봄.
- `bf_log.csv` 16:12쯤의 한 줄(sound 칸 빈 줄)은 앞 4 kHz 녹음을 `--wav`로 다시 계산한 것이라 중복이다.
- 3회(약 ±30°, 1m, B를 조금 가깝게 놓음): 4 kHz −23°·+42° 분리(골 −12.7 dB), 2 kHz 합쳐짐(−1.2 dB), A만 −22°, B만 +45°. 둘 다 +쪽으로 밀린 것은 배치가 비대칭이었기 때문으로 봄.
- 4회(대칭으로 다시 놓음): 4 kHz −39°·+41° 분리(골 −14.4 dB), 2 kHz −43°·+41° 분리(골 −5.0 dB), A만 −39°, B만 +42°. 처음엔 ±30°로 기록했으나 사용자가 확인해 보니 실제로는 약 ±40°에 놓여 있었음. 이 기준으로 오차 1~2°이며, 채널 위치표·각도 부호·마이크 간격 42mm 가정이 맞음을 뒷받침함.
  - `bf_log.csv`의 4회 줄(16:2x)은 true_deg가 ±30으로 적혀 있지만 실제는 약 ±40이다.
- 2 kHz는 60° 간격에서 합쳐지고 80° 간격에서 분리됨: 2 kHz 분리 경계는 60°~80° 사이(이론 약 55°). 4 kHz는 60°·80° 모두 분리.
- 마이크 간격 42mm는 보드 실측(제작 가이드 U1)으로 아직 직접 확인하지 않음.

### 2026-11-04 (계획서 기준의 지연-합 빔포밍)
- 사용자 요청에 따라 방향 계산의 목적·입출력·후속 확장 범위를 먼저 정하고 `작업파일/빔포밍/`을 새로 만듦. 이전 상호상관 연습 코드와 구분함.
- `beamforming.py`: 주파수 영역 지연-합, CSM 평균, Hann 창·50% 겹침, 기온에 따른 음속 보정, 가로 ±90°·세로 ±40° 지도와 최대 방향. 채널 수·무음·비정상 값·배열·주파수 대역을 확인함.
- `simulate.py`, `data_io.py`, `main.py`, `plot_result.py`: 독립 가상 음원, WAV·좌표 CSV 읽기, PNG·JSON·NPZ 저장. 가상 정답은 녹음 생성과 그림 표시에만 사용하고 계산 함수에 주지 않음. 실행마다 새 결과 폴더를 만들고 GitHub 업로드 대상에서 제외함.
- 프로젝트 루트 `.venv`에 NumPy 2.0.2, Matplotlib 3.9.4, SoundFile 0.13.1을 설치함. Python 3.9.6에서 실행함. 자동 녹음·소리 재생·아두이노 명령은 실행하지 않음.
- 테스트 10개: 여러 방향의 대역 잡음, 별도 정현파 생성 방식의 1·2·4kHz, 신호 크기와 파워 비례·정규화, 분석 대역 선택, 두 독립 음원 봉우리, 채널·좌표 동시 순서 변경, 1.5m 구면파, 입력 오류, WAVEX PCM16·PCM24·float 읽기와 좌표 순서 검증. 경고를 오류로 취급하는 실행도 통과함.
- 기본 데모는 가로 +20°·세로 +10°를 찾음. 실제 녹음은 아직 없으며 교실 반사음·실물 오차·고주파 가짜 봉우리에 대한 실험 검증은 하지 않음. 단일 최대점으로 음원 개수를 판정하지 않음.

### 2026-11-04 (방향 추정 연습)
- 소프트웨어 팀의 첫 목표를 마이크 녹음으로 방향을 계산해 그림에 점을 찍는 것으로 정리함. 실제 녹음 파일은 아직 없음.
- `작업파일/방향추정/locate_sound.py`, 마이크 위치 예시 CSV, 사용 안내, 검증 코드를 추가함. 가상 16채널 WAV → 도착 시간차 → 방향 각도 → SVG·JSON 결과 저장 흐름을 구현함. 아두이노 연결·외부 패키지 설치 없이 Python 3.9.6에서 실행함.
- 데모 결과는 가로 약 +20.1°, 세로 약 +9.9°. 별도로 만든 펄스의 네 방향(정면·좌·우·상·하 조합), 무음·채널 수 불일치·일직선 배열 거절, PCM·float·확장 WAV 읽기와 잘린 파일 거절, 그림의 위치와 가상 결과 표시를 테스트 5개로 확인함.
- 이 버전은 일반 상호상관과 평면파 근사로 앞쪽 한 음원의 방향만 추정함. 거리·방 안의 미터 좌표·실시간 카메라 합성은 구현하지 않음. 예시 마이크 위치는 구상도 기준이며 실제 녹음 채널 순서는 미확인. 생성 결과 폴더는 GitHub 업로드 대상에서 제외함.

### 2026-11-04 (소프트웨어: 소리 재생·동시 녹음)
- 팀 구성: 7명, 하드웨어 팀·소프트웨어 팀(3명). 소리 재생 자동화를 소프트웨어 팀원이 맡음. 그 팀원의 작업은 `작업파일/sh/`에서 하고, 필요한 코드는 복사해 와서 씀.
- 팀장 확인 사항: Windows와 Mac 둘 다 지원, UMA-16 녹음과 동시 시작까지 담당, 수집 프로그램에서 불러 쓰는 함수 형태, 실험 2에서 스피커를 하나씩 켜는 기능도 포함.
- `작업파일/sh/`: `sound_io.py`(재생·동시 녹음, 명령과 `SoundIO` 함수), `test_sound_io.py`(장치 없는 시험 8개 통과), `사용법.md`. 패키지는 `작업파일/파이썬/requirements.txt` 범위 안(numpy, sounddevice, soundfile).
- 녹음 방식: 녹음 시작 → 0.3초 뒤 재생 → 소리 끝나고 0.5초 뒤 녹음 정지. 16채널 48 kHz 16비트 wav와 `rec_log.csv`를 `작업파일/sh/기록/`에 저장(`.gitignore`에 추가).
- 이 노트북(Windows)에서 무음 재생으로 출력 장치 동작 확인. 스트림 여닫는 데 약 1초가 더 걸려 수집 속도가 그림 8 추정(1시간 약 1,000개)보다 느려질 수 있음.
- Windows 유선 이어폰 시험 통과: 채널 확인(A 1 kHz → B 2 kHz), 1 kHz를 A만·B만, 실험 2 잡음 AB. 좌우와 높낮이 모두 기대대로 들림. 이어폰을 꽂으면 출력 장치가 "스피커"에서 "헤드폰(WASAPI)"으로 자동으로 바뀜.
- Windows selftest 통과(노트북 스피커 → 내장 마이크, 녹음은 저장 안 함): 1 kHz 3초, 녹음 4.47초. 녹음 시작 0.77초 뒤 소리가 들어오고, 소리가 끝난 뒤 0.70초 더 녹음함. 설정한 앞 여유는 0.3초지만 출력 장치를 여는 데 약 0.47초가 더 걸림. 재생 시작 추정값(`play_offset_s` 0.87초)은 실제보다 약 0.1초 커서 참고용으로만 씀.
- 팀장이 Mac에서 `test_sound_io.py`, 채널 확인 재생, `selftest`를 돌려 통과했다고 알려 옴(출력은 받지 않음).
- 하드웨어 팀이 앰프(PAM8403)·스피커 A·B 배선을 마쳤다고 알려 옴.
- 연습 과제 4: `작업파일/sh/task4_ab_together.py`(A 1 kHz + B 2 kHz 동시, `audio.py`를 sh로 복사해 씀). 코드만 만들고 실행은 하지 않기로 함.
- 실제 스피커 시험 통과: 노트북 이어폰 단자 → 앰프 → 스피커. 채널 확인 소리를 4번씩 반복하며 앰프 볼륨을 최소에서 올려 위치를 정함. 낮은 소리 A, 높은 소리 B, 찌그러짐·웅 잡음 없음(귀로 확인).
- 노트북 마이크로 녹음해 숫자로 확인해 보는 `작업파일/sh/speaker_check.py`를 만들었으나, 인텔 스마트 사운드 마이크 배열의 잡음 제거가 계속되는 순음을 지워(조용한 구간이 완전한 0) 판정에 쓸 수 없었음. 실험 녹음은 UMA-16으로 하므로 실험에는 영향 없음. 앞의 selftest 통과는 소리 시작 시점만 본 것이라 이 문제와 함께 볼 것.
- `turntable.ino`가 로컬에서 내용 변화 없이 들여쓰기·줄바꿈만 바뀌어 있어 사용자 확인 후 원래대로 되돌림.

### 2026-11-04 (소프트웨어: 실제 하드웨어)
- `turntable.ino`에 `o`(벤치 원점) 명령 추가: 리밋 스위치 없이 지금 위치를 0°로 믿고 `g`를 쓸 수 있게 함. 조립 전 책상 위 시험용이며, 실험에서는 `h`로 잡은 원점만 쓴다. 이 환경에서 컴파일은 못 해 봄(아두이노 IDE의 확인 버튼으로 확인 필요).
- `작업파일/파이썬/hw_check.py`: 연결 → 드라이버 → 방향(m10) → 원점(h 또는 o)과 ±60° 왕복 → 리밋 스위치(w) → 스피커 A·B 순서로 움직이고 y/n 답을 받아 `기록/hw_check_날짜.md`에 저장. 실패 항목마다 고칠 곳을 알려 줌.
- `turntable.py`에 `bench_origin()`, 시뮬레이터에 `o`와 스위치 누름 흉내 추가. step1·step3에 `--bench` 옵션 추가.
- README와 소개 페이지에 "실제 하드웨어로 하기"(스케치 업로드, 배선·Vref, 점검, 조립 전/후 실행법)를 넣음.

### 2026-11-04 (소프트웨어)
- 팀원 소개용으로 하드웨어 조작부터 시작하기로 함. 노트북은 Windows·Mac 둘 다 지원.
- `작업파일/파이썬/`: `turntable.py`(시리얼 명령을 함수로 감싼 `Turntable`, 아두이노 없이 연습하는 `FakeArduino` 시뮬레이터 포함), `audio.py`(순음, 스피커 A=왼쪽·B=오른쪽 재생), `step0_check_devices.py`(패키지·포트·오디오 장치 확인), `step1_turntable.py`(직접 조작·데모), `step2_play_sound.py`(채널 확인 wav·순음), `step3_rotate_and_play.py`(돌리기-기다리기-소리 반복, `기록/`에 csv), `requirements.txt`, `README.md`.
- 시뮬레이터로 step1·step3과 오류 응답(원점 없이 g, m 범위 초과)을 확인함. 소리 재생은 이 환경에 오디오 장치가 없어 실행해 보지 못함.
- `.gitignore`에 `.venv/`와 `작업파일/파이썬/기록/`을 추가함.
- 팀 소개 페이지 `문서/소프트웨어_첫걸음.html`: 연결도, 시리얼 명령과 파이썬 함수 대응표, 설치(Windows/Mac), step0~3 따라 하기, 연습 과제 4개, 앞으로의 순서.
- 오전에 연결이 끊겨 못 옮긴 제작 가이드와 진행상황을 로컬 폴더에 반영함.

### 2026-11-04
- UMA-16을 뺀 부품이 모두 도착함.
- 제작 가이드와 부품 설계도를 만듦(`문서/음향카메라_제작가이드.html`, claude.ai 아티팩트). 실측값을 넣으면 확인 결과와 단면도가 바뀜.
  - 구성: 실측표, 팀 논의 D1~D7, 전체 단면, 부품 도면(모터판·회전판·세움판·받침대·바닥판·옆벽), 조립 15단계, 스피커 통, UMA-16 도착 후, 추가 구입.
  - 새 제안(팀 논의 전): 레이지수전 볼트는 머리만 두 판 사이에 넣음, 리밋 스위치는 모터판 위에 눕히고 회전판 앞-왼쪽 모서리의 트리거 볼트(M3×20, 축에서 115)가 누름, 세움판 앞면은 축에서 뒤로 11.6, 받침대 60×100 삼각형, 스피커 통 80×80×100(스피커는 앞판 바깥).
  - 찾은 점: 회전판을 덮은 뒤에는 레이지수전 아랫판 구멍에 손이 닿지 않음(접근 구멍 방식 필요), M3×16을 플랜지에도 쓰면 2개 모자람, 세움판 나사 일부가 레이지수전 윗판에 덮이므로 세움판을 먼저 붙여야 함.

### 2026-11-03
- 폴더를 GitHub 공개 저장소 `syw963/newton-acoustic-camera`에 올림(파일 36개, `.DS_Store` 제외).
- 요구서 xls 2개와 `작업파일/요구서/` xlsx 2개는 요구자 실명이 들어 있어 올리지 않음. `.gitignore`에 넣어 앞으로도 올라가지 않게 함.
- 로컬 폴더를 git 저장소로 연결함. 한글 파일·폴더 이름을 NFC로 바꿔 GitHub 쪽 이름과 맞춤(보이는 이름은 같음). 이 폴더에는 GitHub 로그인 정보가 없어서, push는 Claude 세션에서 하거나 Mac의 git/GitHub Desktop으로 한다.

### 2026-10-26 (설계 검토 반영)
- 폴더 전체를 검증함. 요구서 합계·수식·배송비 내역, xls와 작업본 일치, 계획서 pdf와 docx 일치, 구상도 동작은 문제없음.
- 두 차례 검토 의견을 비교해 실험 설계를 고침.
  - 실험 1: 6·8 kHz 추가, 3회 반복, 계산 범위 ±90°, 치우침과 흩어짐을 나눠 보고, 회전 데이터로 빔 패턴(빔 폭) 측정.
  - 실험 2: 1·2·4 kHz 순음 → 2·4·6·8 kHz 1/3옥타브 대역 잡음(좌우 다른 난수). 시작 Δθ를 주파수별로(90°/50°/30°). Δθ는 회전판으로 측정. "4 kHz 이상에서 앨리어싱" 서술이 틀려 고침(4 kHz 이하에서는 생기지 않음).
  - 실험 3: 무작위 연속 각도로 학습, 시험 데이터는 다른 공간·날·거리에서 따로 수집(data leakage 방지), 50회마다 원점 재확인, SRP-PHAT·MUSIC도 비교.
- 설계 추가: 커플링 조립 순서, 리밋 스위치 위치(−70°, 여분은 +70° 비상 정지), 녹음 중 드라이버 끄기 테스트, PAM8403 BTL 배선 주의, 책상 반사.
- 드라이버를 끄면 모터가 1.8° 정지 위치로 끌려갈 수 있어, 끄기 전에 각도가 밀리는지 확인하는 단계를 넣음.
- 실험 계획서 수정판 생성(4쪽). 이전 제출본과 초안은 `문서/보관/`으로 옮김. 생성 스크립트는 `content.py` 하나를 고치면 pdf·docx가 함께 바뀌도록 정리하고 경로를 폴더 기준으로 바꿈.
- 새 파일: `문서/배선_작업순서.md`, `작업파일/아두이노/turntable/turntable.ino`(원점 찾기·절대 각도 이동·리밋 확인), `작업파일/신호/make_signals.py`와 생성된 wav 13개.
- 구상도 html 수정: 그림 4 조립 순서·0° 맞추기·드라이버, 그림 7 스피커 선 2쌍·리밋 위치, 그림 8 무작위 각도 수집·시험 데이터 분리, 그림 9 제목(실험 1·2).
- 프로젝트 소개 문서(md, docx) 맨 앞에 10/7 구버전이라는 안내를 넣음.

### 2026-10-26
- 장치 구상도(HTML 아티팩트)를 최신 설계로 고침.
  - 회전판 단면도: 12mm 자작합판, 레이지수전(M4×20), 회전판 아랫면 커플링과 Ø8 구멍, M3×16, M3 서포트, 리밋 스위치, 높이 200mm.
  - 재단도: MDF → 자작합판 12mm, 모터판 Ø25·세움판 Ø32(스페이드 비트), HSS 비트 구멍.
  - 배선도: 블루투스·스마트폰 대신 노트북 이어폰 단자 → PAM8403 → 스피커 A(L)·B(R), 앰프 USB 5V 전원, USB-C 허브, 리밋 스위치 → X−.
  - 0°는 리밋 스위치로 원점을 잡고 카메라 십자선으로 맞춤. 실험 번호를 현재 계획(실험 2 = 분해능)에 맞춤.
- 프로젝트 소개 문서(docx, md), 장치 구상도(html), 실험 계획서 초안(pdf)을 `문서/`와 claude.ai 프로젝트에 올림.
- claude.ai 프로젝트 "뉴턴 음향카메라"와 로컬 폴더 `Newturn_sc`로 작업 장소를 옮김. 진행 기록과 지침을 정리함.

### 2026-10-15
- 선생님이 "품목이 너무 많다"며 실험별 사용처를 설명하는 실험 계획서를 요청함.
- 실험 계획서 작성: 4쪽, 하다체, 금액 없음, 흑백. 구성은 실험 개요, 구입 물품의 구성, 장치 제작, 실험 1~3, 안전 수칙, 물품별 사용 단계 표.
- 수정할 수 있도록 docx로도 만듦.

### 2026-10-14
- 100만 원 버전 인두기 변경 과정
  - 처음에는 세라믹 세트였다.
  - 온도조절 디지털 스테이션을 거쳐 하코 FX-600으로 정함.
  - FX-600을 넣는 대신 헬핑핸드와 거치대는 확대경 스탠드 하나로 합쳤다.
  - 톱과 온습도계는 싼 것으로 바꾸고, 고무발과 케이블타이는 뺐다.
- 네이버의 "하코 FX-888D 8만 원" 상품은 정품이 아닐 가능성이 커서 넣지 않음.
- 최종 점검에서 판매 종료 2건을 처리함.
  - 플랜지 커플링 → 트레이드셀50 상품으로 교체
  - 스테핑모터 케이블 → 모터에 포함되어 있어 삭제
- 드릴 가격을 사용자 화면의 자동적용 쿠폰 반영가 89,810원으로 수정. 충전기 포함을 사진으로 확인함.
- 알리익스프레스 전환을 검토했지만 하지 않기로 함 (학교 결제 절차, KC 인증, 배송 기간, 관세 합산 문제).

### 2026-10-13
- 오늘 기준으로 재검토함.
  - PAM8403 앰프가 판매 종료돼 동신전자 PP-A193으로 바꾸고 USB 전원 케이블을 추가함.
  - 쿠폰이 바뀐 품목을 반영하고, 옛 설명 문구를 정리함.
- 100만 원 이하 버전을 만듦 (드릴, 인두기, 포스너 비트를 낮은 등급으로 바꾸고 판매처를 묶음).

### 2026-10-12
- 판재를 MDF 9mm에서 자작합판 12mm로 바꿈. 재단 치수는 그대로 둠.
- 레이지수전 회전 베어링을 추가함.
- M3×16 볼트, M3 서포트, 목재 나사 3.5×32를 추가함.
- 공구와 부속을 추가함: 육각렌치, F클램프, 직각자, 샌딩스펀지, 리밋 스위치, 고무발, 케이블타이.
- 레이저 포인터는 넣었다가 뺐다 (카메라 십자선으로 0°를 맞추기로 함).
- 멀티미터를 교체하고, 11번가 자동적용 쿠폰 가격을 반영함.

### 2026-10-11 이전
- 프로젝트 방향 설정: 음향카메라 구조 이해, 회전판 방식, 탐구 질문 3개, 8주 계획.
- 소개 문서(Claude Docs)와 장치 구상도(HTML)를 만듦.
- 구입 요구서를 처음 작성함: 11번가 위주로 구매처를 조사했고, 납땜 용품·드릴·멀티미터 등을 추가함.
