syw963/newton-acoustic-camera/(commit log)

2026-11-03 뉴턴 음향카메라 프로젝트 폴더 첫 업로드
    Claude-Session: https://claude.ai/code/session_017tnjcTCefKqVoy8bf5iud9
2026-11-03 진행상황: GitHub 업로드 기록
    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
2026-11-03 진행상황: 로컬 폴더 git 연결 기록
    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
2026-11-04 README: 요구서 금액 삭제
    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
2026-11-04 소리 방향 추정 연습 프로그램과 사용 안내 추가
    [mic_positions_example.csv]
2026-11-04 소리 재생·UMA-16 동시 녹음 프로그램 추가 (작업파일/sh)
    - sound_io.py: 스피커 A/B/AB 재생, 녹음 먼저 시작 후 재생, Windows·Mac 공용
    - test_sound_io.py: 장치 없는 시험
    - 사용법.md, 진행상황·설계 기록, sh/기록 gitignore
2026-11-04 진행상황: 소리 재생 이어폰 시험 통과 기록
2026-11-04 소리 재생: Windows selftest 통과 기록, 안내 문구 수정
2026-11-04 연습 과제 4: A 1 kHz + B 2 kHz 동시 재생 (sh, audio.py 복사)
2026-11-04 진행상황: Mac 시험 통과, 앰프·스피커 배선 완료 기록
2026-11-04 소리 재생: 실제 스피커 시험 통과 기록, speaker_check.py 추가
2026-11-11 빔포밍 방향 계산과 공유용 결과 그림·CSV 추가
    [direction_curve.csv, mic_positions_example.csv, power_map.csv, summary.csv]
2026-11-11 UMA-16 채널 위치표 작성, uma_check.py 긁기 판정 수정
    [uma_check.py]
2026-11-11 UMA-16 위치표 기준 방향 기록 (USB 단자 아래)
2026-11-11 진행상황: 빔포밍 코드와 결과 GitHub 공유 완료 기록
2026-11-11 16채널 녹음 + 지연-합 빔포밍 첫 시험 (beamform.py, step4_beamform.py)
2026-11-11 빔포밍: 여러 봉우리·골 깊이 판정 추가, A·B 동시 시험 기록
2026-11-11 UMA-16 녹음 후 방향 계산과 결과 저장 연결
    [mic_positions_uma16_usb_down.csv]
2026-11-11 진행상황: A·B 동시 빔포밍 3·4회 결과 기록 (±40° 배치, 오차 1~2°)
2026-11-12 회전판 제작 가이드 단순판, 모터판 구멍 본, 음향카메라 실시간 화면 추가
2026-11-12 진행상황: 음향카메라 화면 기록
2026-11-13 딥러닝 학습 파이프라인: 수집, GCC-PHAT 특징, 학습, 4가지 방법 비교
